knedl1k/decaf/sw/README.md

# Dir Structure

- [**`arduino`**](./arduino): code ran on Arduino.
- [**`graphs`**](./graphs): code to generate data for TikZ scripts.
- [**`recognition`**](./recognition): whole pipeline for training, evaluating,
and deploying the *decaf* model.
