knedl1k/decaf/thesis/src/acknowledgments.tex

%!TEX root = ../main.tex

\begin{changemargin}{0.8cm}{0.8cm}

~\vfill{}

\section*{Acknowledgments}
\vskip 0.5em
I would like to express my gratitude to my thesis supervisor, Ing. Jakub Paplhám, for his valuable guidance, advice and time dedicated to this work. I would also like to thank my colleague Martin Erben for helpful discussions during the preparation of this thesis and throughout our entire studies. Finally, my special thanks go to my girlfriend Natália and my family for their continuous support and encouragement throughout my studies.

\vskip 1em

The access to the computational infrastructure of the \href{https://opvvv.msmt.cz}{OP VVV} funded project \texttt{CZ.02.1.01\slash 0.0\slash 0.0\slash 16\_019\slash 0000765} \enquote{\href{https://rci.cvut.cz}{Research Center for Informatics}} is also gratefully acknowledged.

\vskip 2.5cm

\end{changemargin}
