knedl1k/decaf/thesis/src/disclaimer.tex

%!TEX root = ../main.tex

\begin{changemargin}{0.8cm}{0.8cm}

~\vfill{}

\section*{Disclaimer}
\vskip 0.5em
All trademarks, service marks, trade names, and product names mentioned in this thesis (e.g., \ii{Magic: The Gathering}, \ii{Pokémon}, \ii{Yu-Gi-Oh!}) are the property of their respective owners. Their use in this document is for identification and academic purposes only and does not imply endorsement. Card imagery and graphical assets used in this thesis remain the intellectual property of their original publishers.

\vskip 2.5cm

\end{changemargin}
