knedl1k/decaf/thesis/src/abbreviations.tex

%!TEX root = ../main.tex

\acro{arcface}{ArcFace}{Additive Angular Margin Loss}
\acro{GPIO}{GPIO}{General-purpose input/output}
\acro{PWM}{PWM}{Pulse Width Modulation}
\acro{ONNX}{ONNX}{Open Neural Network Exchange}
\acro{SGD}{SGD}{Stochastic Gradient Descent}
\acro{CNN}{CNN}{Convolutional Neural Network}
\acro{SBC}{SBC}{Single Board Computer}
\acro{BOM}{BOM}{Bill of Materials}
\acro{CTU}{CTU}{Czech Technical University}
\acro{TCG}{TCG}{Trading Card Game}
\acro{FOSS}{FOSS}{Free and open-source software}
\acro{OCR}{OCR}{Optical Character Recognition}
\acro{NER}{NER}{Named Entity Recognition}
\acro{YOLO}{YOLO}{You Only Look Once}
\acro{ResNet}{ResNet}{Residual neural network}
\acro{VSL}{VSL}{Visual Similarity Learning}
\acro{DFC}{DFC}{Double-Faced card}
\acro{UUID}{UUID}{Universally unique identifier}
\acro{URI}{URI}{Uniform Resource Identifier}
\acro{MTG}{MTG}{\ii{Magic: The Gathering}}
\acro{DML}{DML}{Deep Metric Learning}
\acro{FMR}{FMR}{False Match Rate}
\acro{TMR}{TMR}{True Match Rate}
\acro{DDP}{\texttt{DDP}}{\texttt{DistributedDataParallel}}
\acro{GIL}{GIL}{Global Interpreter Lock}
\acro{STR}{STR}{Scene Text Recognition}
