knedl1k/decaf/thesis/src/chapters/05_software.tex

%!TEX root = ../main.tex

\chapter{System Implementation \& Integration}\label{chap:sw}
The software ecosystem of the robotic sorter spans two distinct computing environments: a high-performance cluster for model optimization and a low-power edge computing architecture for real-time robotic control and inference. This chapter details the implementation of both systems and their integration.

\section{Scalable Training Architecture}
Training a deep metric learning model on a dataset with extreme cardinality introduces significant computational bottlenecks. Specifically, the weight matrix $\mathbf{W}$ in the \ac{arcface} head requires substantial VRAM, scaling linearly with the number of unique cards. To address this, the training pipeline was designed for high-throughput distributed execution.

\subsection{Distributed Data Parallelism and Synchronization}
The model optimization is parallelized across multiple compute nodes and accelerators using PyTorch's~\cite{paszke2019pytorch} \ac{DDP}. Unlike standard \texttt{DataParallel}, which suffers from Python \ac{GIL} contention and uneven memory distribution, \ac{DDP} spawns independent processes for each device.

To manage the massive 150+\,GB dataset of clean templates, a \texttt{DistributedSampler} is employed within the data loading pipeline. It mathematically partitions the dataset indices among the active workers. For instance, in a 4-GPU topology, each device independently loads and processes exactly 25\,\% of the dataset per epoch. The \ac{DDP} backend (via the NCCL protocol) then asynchronously synchronizes the calculated gradients across all nodes before the optimizer steps, drastically reducing training times.

However, running small batches on individual GPUs severely destabilizes the mean and variance calculations inside standard Batch Normalization layers. To maintain mathematical consistency across distributed workers, standard layers were replaced with Synchronized Batch Normalization (\texttt{SyncBatchNorm}). This ensures that the variance and mean are computed globally across all participating devices, stabilizing the embedding space optimization.

\subsection{Mixed Precision Training}
To further optimize the memory footprint and memory bandwidth, \ii{mixed precision} was integrated into the training loop. The forward pass and loss computation are executed in \texttt{bfloat16} (Brain Floating Point)~\cite{kalamkar2019bfloat}, a format that preserves the dynamic range of 32-bit floats while halving the memory requirement. The weights and optimizer states remain in \texttt{float32} to prevent precision degradation during gradient updates. This approach effectively doubles the maximum allowable batch size, leading to smoother gradient estimates and faster convergence.

\section{Edge Vision Pipeline}
Once the network is trained, it must be deployed to the \ac{SBC} (Raspberry Pi) governing the robotic platform. And because the \ac{SBC} operates with strict computational and memory constraints (1\,GB RAM and a low-power CPU), the software pipeline must be optimized.

\subsection{Image Localization and Homography}
Before the captured image is passed to the neural network, the physical card must be accurately localized. Simple bounding-box detection (e.g., standard Canny edge detection) frequently fails due to dual borders introduced by plastic card sleeves and severe specular highlights breaking the continuous edge lines.

To resolve this, an OpenCV algorithm was implemented, as formalized in \Cref{alg:crop_card}. The preprocessing sequence proceeds as follows:
\begin{enumerate}
    \item \ii{Filtering}: The raw camera frame is converted to grayscale and passed through a Bilateral Filter. This preserves sharp edges while smoothing out the background texture (e.g., a wooden table).
    \item \ii{Morphological Closing}: After applying a Canny edge detector, a morphological closing operation (using a $9 \times 9$ kernel) is performed. This step is critical, as it mathematically bridges the gaps in the edge map caused by bright light reflections on the card sleeves.
    \item \ii{Minimum Area Rectangle}: Instead of tracing exact polygons, the algorithm extracts the \texttt{minAreaRect} of the largest contour. This cleanly bounds the card while ignoring bent corners or crinkled sleeve edges.
    \item \ii{Perspective Warp}: The four corners of the rectangle are ordered and mapped to a fixed matrix. A perspective transform (homography) is then applied to extract a perfectly orthogonal, standardized card image.
\end{enumerate}

\begin{algorithm}[htbp]
    \caption{Card Localization and Homography Extraction}
    \label{alg:crop_card}
    \begin{algorithmic}[1]
    \Require Raw high-resolution image $I_{\text{raw}}$, Target Width $W$, Target Height $H$
    \Ensure Orthogonally warped card image $I_{\text{crop}}$

    \State $I_{\text{work}} \gets \text{Downscale}(I_{\text{raw}})$ \Comment{Optimizes processing speed on \ac{SBC}}
    \State $I_{\text{gray}} \gets \text{RGBtoGrayscale}(I_{\text{work}})$
    \State $I_{\text{blur}} \gets \text{BilateralFilter}(I_{\text{gray}}, d=11, \sigma_{\text{color}}=75, \sigma_{\text{space}}=75)$
    \State $I_{\text{edges}} \gets \text{CannyEdgeDetector}(I_{\text{blur}}, \tau_{\text{low}}=30, \tau_{\text{high}}=150)$
    \State $K \gets \text{RectangularKernel}(9 \times 9)$
    \State $I_{\text{closed}} \gets \text{MorphologicalClose}(I_{\text{edges}}, K)$ \Comment{Bridges gaps caused by glare}
    \State $\mathcal{C} \gets \text{FindContours}(I_{\text{closed}})$
    \If{$\mathcal{C}$ is empty}
        \State \Return $\text{Resize}(I_{\text{raw}}, W, H)$ \Comment{Fallback if detection fails}
    \EndIf
    \State $c_{\text{max}} \gets \arg\max_{c \in \mathcal{C}} \text{Area}(c)$
    \State $rect \gets \text{MinAreaRect}(c_{\text{max}})$ \Comment{Ignores bent corners and sleeve artifacts}
    \State $P_{\text{src}} \gets \text{OrderPointsToCorners}(rect)$ \Comment{Top-Left, Top-Right, Bottom-Right, Bottom-Left}
    \State $P_{\text{src}} \gets P_{\text{src}} \times \text{UpscaleFactor}$ \Comment{Map coordinates back to original high-res image}
    \State $P_{\text{dst}} \gets \{(0,0), (W,0), (W,H), (0,H)\}$
    \State $M \gets \text{GetPerspectiveTransform}(P_{\text{src}}, P_{\text{dst}})$
    \State $I_{\text{crop}} \gets \text{WarpPerspective}(I_{\text{raw}}, M, W, H)$
    \State \Return $I_{\text{crop}}$
    \end{algorithmic}
\end{algorithm}

\subsection{\acs{ONNX} Runtime and Sequential Inference}
Running a full PyTorch environment on the Raspberry Pi introduces an unacceptable memory overhead. Therefore, the trained \ac{ResNet}-50 backbone is exported to the \acf{ONNX} format~\cite{onnxruntime}, stripping away the \ac{arcface} head and all gradient-tracking graphs. Inference is executed via the \texttt{ONNX Runtime} using the \texttt{CPUExecutionProvider}.

Because cards can be placed onto the sorting platform in any orientation, the system must process the image safely. Instead of batching the original and a $180^\circ$ rotated copy into a single tensor (which spikes memory consumption and risks an Out-Of-Memory termination on the \ac{SBC}), the pipeline executes sequentially. The system extracts a 512-dimensional vector for both orientations individually, $L_2$-normalizes them, and selects the vector that yields the highest cosine similarity against the database. 

The reference database itself is stored as a compressed \texttt{.npz} file containing pre-computed NumPy matrices, enabling instantaneous vector dot-products to determine the final card identity. The complete sequential inference logic, designed specifically for resource-constrained environments, is detailed in \Cref{alg:inference}.
\begin{algorithm}[htbp]
    \caption{Resource-Constrained Orientation Selection and Retrieval}
    \label{alg:inference}
    \begin{algorithmic}[1]
    \Require Cropped Image $I_{\text{crop}}$, ONNX Model $\mathcal{M}$, Database Matrix $\mathbf{D}$, Top-$k$
    \Ensure Best matching card identity and orientation

    \State $I_0 \gets \text{Preprocess}(I_{\text{crop}})$
    \State $I_{180} \gets \text{Preprocess}(\text{Rotate180}(I_{\text{crop}}))$

    \Comment{Sequential execution to prevent Out-Of-Memory errors on the \ac{SBC}}
    \State $\mathbf{v}_0 \gets L_2\text{Normalize}(\mathcal{M}\text{.forward}(I_0))$
    \State $\mathbf{v}_{180} \gets L_2\text{Normalize}(\mathcal{M}\text{.forward}(I_{180}))$

    \State $\mathbf{s}_0 \gets \mathbf{v}_0 \cdot \mathbf{D}^\intercal$ \Comment{Compute cosine similarities against the entire database}
    \State $\mathbf{s}_{180} \gets \mathbf{v}_{180} \cdot \mathbf{D}^\intercal$

    \If{$\max(\mathbf{s}_{180}) > \max(\mathbf{s}_0)$}
        \State $\mathbf{s}_{\text{best}} \gets \mathbf{s}_{180}$
        \State $\text{orientation} \gets 180^\circ$
    \Else
        \State $\mathbf{s}_{\text{best}} \gets \mathbf{s}_0$
        \State $\text{orientation} \gets 0^\circ$
    \EndIf

    \State $\mathcal{I}_{\text{topK}} \gets \text{GetIndicesOfLargest}(\mathbf{s}_{\text{best}}, k)$
    \State \Return $\text{DatabaseNames}[\mathcal{I}_{\text{topK}}], \text{orientation}$
    \end{algorithmic}
\end{algorithm}

\section{Hardware Control Software}
The physical operation of the robot relies on a master-slave software architecture, dividing responsibilities between asynchronous high-level logic and real-time execution. The Arduino Uno acts as the slave device, executing a deterministic control loop. It communicates with the Raspberry Pi (the master) via a standard USB serial interface operating at a baud rate of 57,600 bps.

\subsection{Closed-Loop Positional Control}
While stepper motors are typically driven in an open-loop configuration, this system implements a closed-loop positioning algorithm to prevent mechanical drift and missed steps. 

The absolute rotational position of the main arm is continuously monitored using the AS5147 magnetic encoder. To bypass hardware SPI constraints and pin conflicts, the microcontroller queries the sensor using a custom software SPI implementation (bit-banging) adapted from an existing open-source routine\footnote{The bit-banging implementation for the AS5147 encoder was adapted from \cite{mcr2019as51457}, licensed under GNU GPLv3.}. The raw 14-bit positional data is extracted, validated via a parity bit check and converted into an angular value ($-180^\circ$ to $180^\circ$).

The motion is controlled by a target-seeking loop. The Arduino pulses the TMC2209 driver, stepping the motor while continuously re-evaluating the encoder position. Movement stops only when the absolute angular error falls within a defined tolerance ($\pm 0.5^\circ$) or an overshoot is detected. Although this basic approach guarantees target acquisition, the abrupt termination of movement can cause minor mechanical oscillations at the target workstations. To achieve smoother deceleration and stabilization, future firmware versions will replace this logic with a full Proportional-Integral-Derivative (PID) control scheme. The current control flow is outlined in \Cref{alg:closed_loop}.
\begin{algorithm}[htbp]
    \caption{Closed-Loop Stepper Motor Positioning}
    \label{alg:closed_loop}
    \begin{algorithmic}[1]
    \Require Target angle $\theta_{\text{target}}$, Tolerance $\tau$ (e.g., $0.5^\circ$)
    \Ensure Manipulator reaches $\theta_{\text{target}}$ without mechanical oscillation
    
    \State $e_{\text{prev}} \gets 0$
    \State $\text{first\_run} \gets \text{True}$
    
    \Loop
        \State $\theta_{\text{current}} \gets \text{ReadEncoderData}()$ \Comment{Via bit-banged SPI}
        \State $e \gets \theta_{\text{target}} - \theta_{\text{current}}$
        
        \Comment{Terminate if within tolerance or an overshoot occurs}
        \If{$|e| \leq \tau$ \textbf{or} (\textbf{not} $\text{first\_run}$ \textbf{and} $e \cdot e_{\text{prev}} < 0$)}
            \State \textbf{break}
        \EndIf
        
        \State $\text{first\_run} \gets \text{False}$
        \State $e_{\text{prev}} \gets e$
        
        \If{$e > 0$}
            \State $\text{SetMotorDirection}(\text{FORWARD})$
        \Else
            \State $\text{SetMotorDirection}(\text{REVERSE})$
        \EndIf
        
        \State $\text{PulseStepperDriver}()$
        \State $\text{Wait}(\text{STEP\_DELAY})$
    \EndLoop
    \end{algorithmic}
\end{algorithm}

\subsection{Kinematic Sequences and Synchronization}
To minimize the communication overhead between the Raspberry Pi and the Arduino, the low-level mechanical synchronization is abstracted into three hard-coded macro sequences. The master device issues a single ASCII character (\texttt{'A'}, \texttt{'B'} or \texttt{'C'}), prompting the Arduino to autonomously orchestrate the main stepper, the Z-axis servo and the pneumatic solenoid.

These sequences correspond directly to the physical workstations illustrated in \Cref{fig:system_overview}:
\begin{itemize}
    \item \bb{Sequence A (Input):} The arm traverses to the input hopper. The Z-axis servo lowers the end-effector, the 24\,V solenoid valve is energized to generate a vacuum and the card is lifted.
    \item \bb{Sequence B (Inspection):} The arm moves the card into the camera's field of view. Once the arm stabilizes, the Arduino transmits an \texttt{"R"} (Ready) character back over the serial interface. This acts as a hardware trigger for the Raspberry Pi to capture the image.
    \item \bb{Sequence C (Output):} The arm proceeds to the output sorting tray, lowers the Z-axis and de-energizes the solenoid. This vents the pneumatic circuit to the atmosphere, safely releasing the card.
\end{itemize}
