knedl1k/decaf/presentation/slides/1_2026/main.pdf

## Automated Recognition and

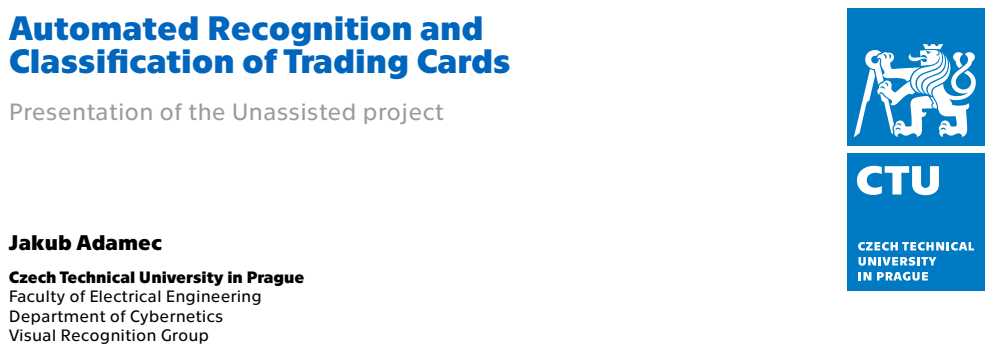
[picture p11: page 1]

Classification of Trading Cards

Presentation of the Unassisted project

Jakub Adamec
Czech Technical University in Prague
Faculty of Electrical Engineering
Department of Cybernetics
Visual Recognition Group

### Motivation and Objective

The problem

I Manual sorting of trading cards (TCG) is time-consuming and prone to errors. I Existing commercial solutions (e.g., CardBot) are proprietary and/or expensive. I Many different similar cards. MTG has >100k unique cards.

Objectives of the work

I Software: Recognition pipeline that recognizes cards even from poor-quality photos.
I Hardware: Affordable and widely available components (Arduino, stepper motors...).
I The entire project FOSS and well documented so that it can serve as educational material.
1 / 7 | Jakub Adamec

### Hardware: Concept

I Focus on affordable components.
I Vacuum suction cups, stepper motor, pneumatic valve, hall encoder.
I Milestone reached: Precise stepper motor control using rotation encoders feedback loop.

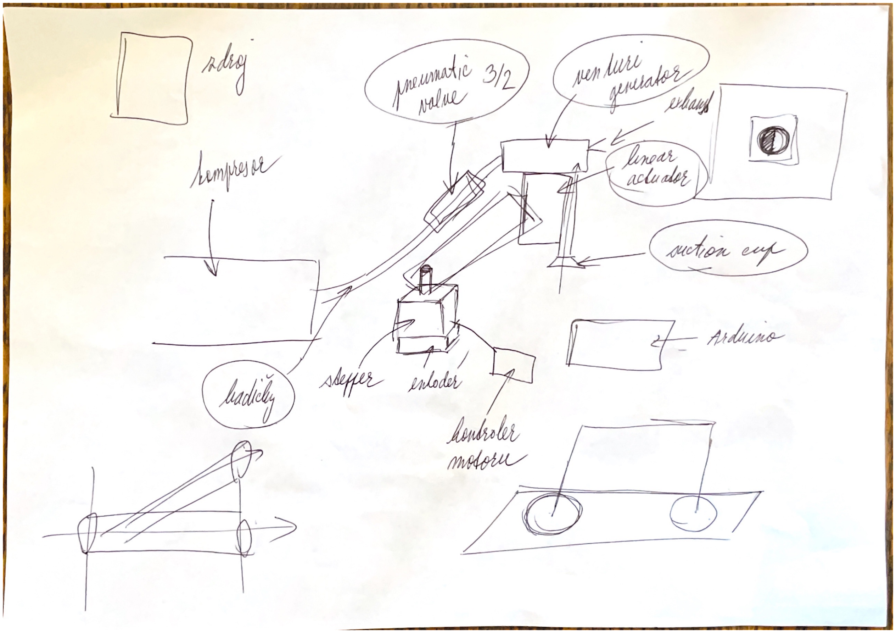
[picture p12: figure]

2 / 7 | Jakub Adamec

### Data Acquisition & Augmentation

Synthetic Dataset Generation
I Real-world labeled dataset is non-existent. I Scans retrieved via Scryfall API.
I Custom naming convention for human-readability & uniqueness:

Bridge the Domain Gap
I Heavy augmentation pipeline required to match camera output.
I Geometric: Random perspective, rotation. I Photometric: Blur, noise, lighting conditions, partial occlusions.

## filename = edition_collectorNumber_name-UUID.png zen_21_kor-outfitter-00006596-1166-4a79-8443-ca9f82e6db4e.png

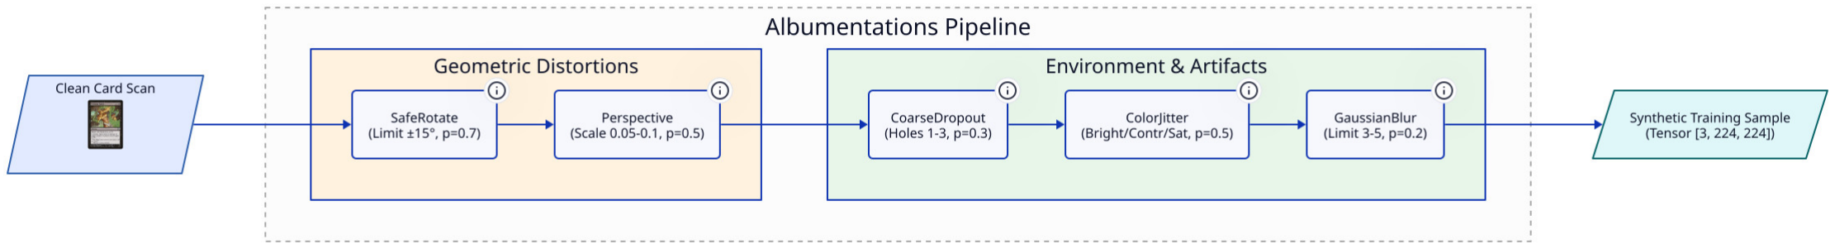
[picture p13: figure]

3 / 7 | Jakub Adamec

### Softmax vs ArcFace

Limitations of Standard Softmax

I Huge number of classes (10⁵+) → computationally expensive. I Open-set problem: New cards are released frequently.

Metric Learning Approach (ArcFace)

I Learning a mapping to a hypersphere embedding space.
I Intra-class compactness. Images of the same card are pulled together. I Intra-class separability. Different cards are pushed apart.
I Inference via Cosine Similarity (Nearest Neighbor).
4 / 7 | Jakub Adamec

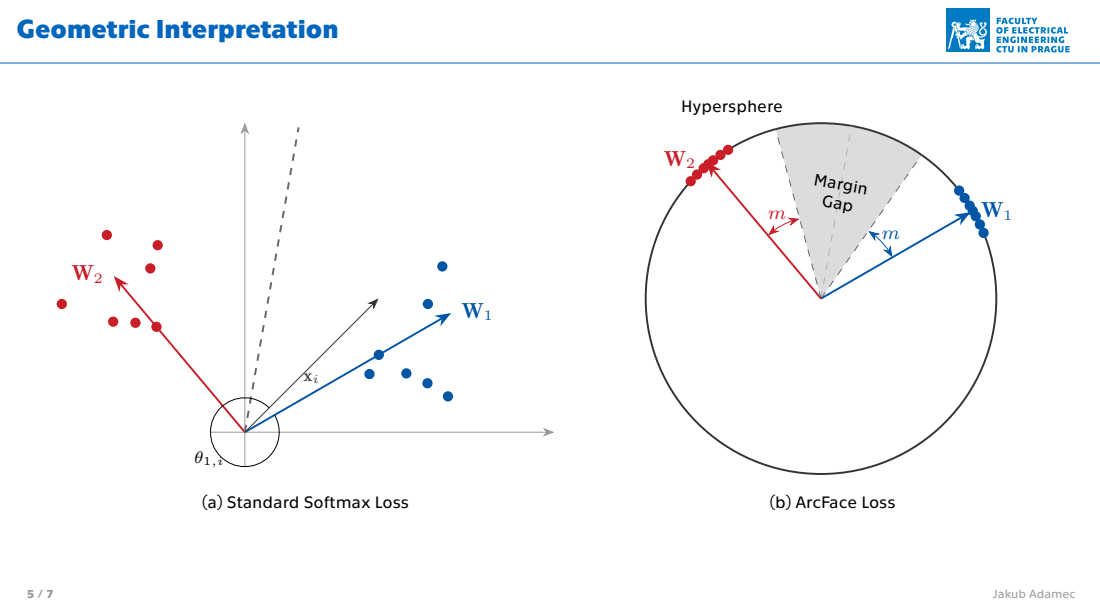
[picture p14: page 6]
Geometric Interpretation; Hypersphere; Margin Gap; (b) ArcFace Loss; Jakub Adamec

(a) Standard Softmax Loss

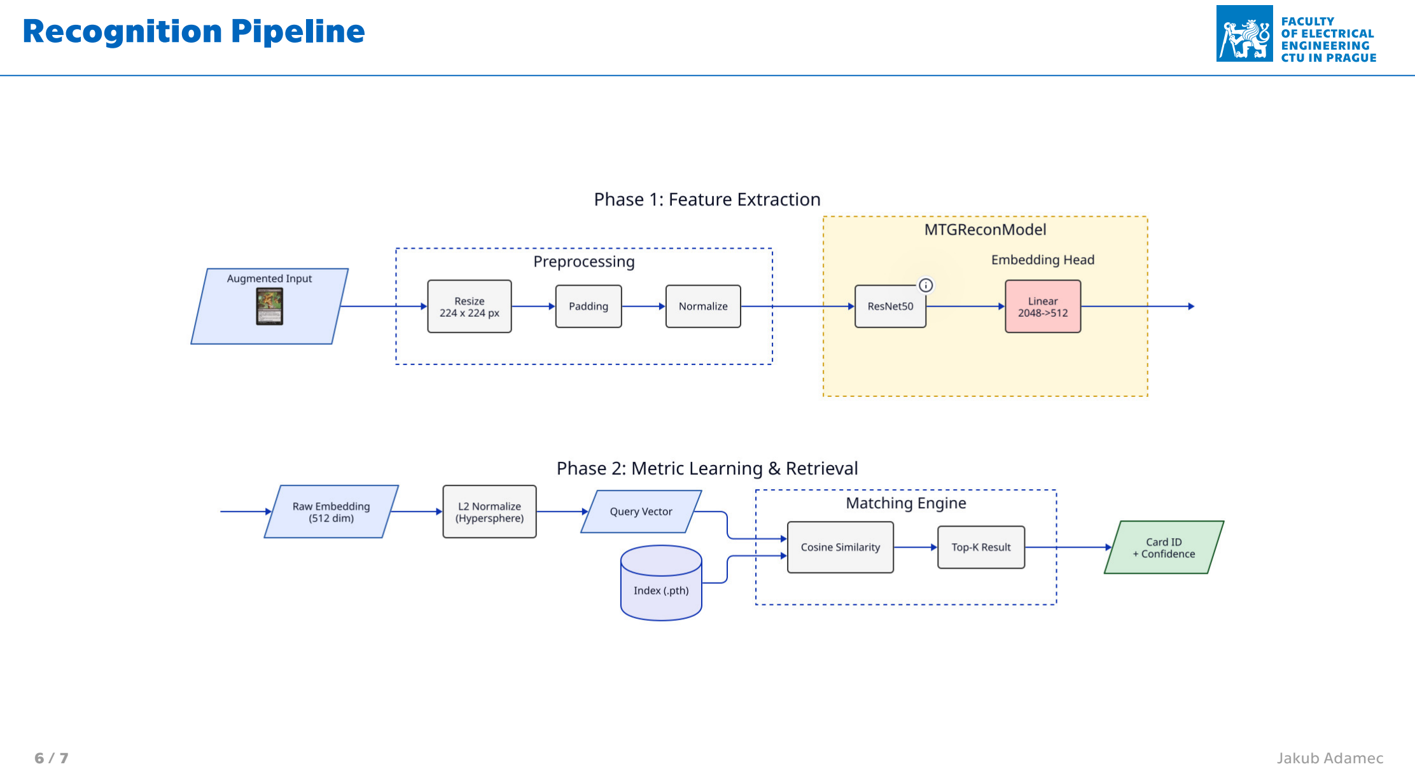
[picture p15: page 7]

### Recognition Pipeline

6 / 7 | Jakub Adamec

### Conclusion and Future Work

Summary

I Basic HW control operational.
I Recognition pipeline implemented (Synthetic Data + ArcFace). I Support for MultiGPU training.

Next Steps

I Hyperparameter sweep (Weights & Biases).
I Finalize mechanical construction.
I Full integration of the recognition module with the robotic control. I Final evaluation on a physical test set.
7 / 7 | Jakub Adamec
