knedl1k/decaf/thesis/main.tex

% enable this to activate the version for PRINT
% disable this to make the pdf symmetric and without white pages
% => asymmetric alternating left/right margins
% \newcommand*{\printversion}{}%

%% | ---------------- document meta information --------------- |

\newcommand{\Author}{Jakub Adamec}
\newcommand{\Department}{Department of Cybernetics}
\newcommand{\Supervisor}{Ing. Jakub Paplhám}
% \newcommand{\SupervisorSpecialist}{Ing. My Specialist, Ph.D.}
\newcommand{\Programme}{Open Informatics}
\newcommand{\Field}{Artificial Intelligence and Computer Science}
\newcommand{\Title}{Automated Recognition and\texorpdfstring{\\[0.5em]}{ }Classification of Trading Cards}
\newcommand{\Keywords}{Trading Card Games, Magic: The Gathering, Automated Sorting, Deep Metric Learning, Computer Vision, ArcFace, Nearest Neighbor Search, Synthetic Data Generation, Domain Shift, Image Retrieval, Open-Source Hardware, Robotics, Pick-and-Place Mechanism, Pneumatic Handling.}
\newcommand{\KlicovaSlova}{Sběratelské karetní hry, Magic: The Gathering, automatizované třídění, hluboké metrické učení, počítačové vidění, ArcFace, hledání nejbližšího souseda, generování syntetických dat, posun domény, vyhledávání obrázků, open-source hardware, robotika, pick-and-place mechanismus, manipulace pomocí podtlaku.}
% \newcommand{\Year}{}
% \newcommand{\Month}{December}
\newcommand{\Date}{\today}
\newcommand{\Location}{Prague}

%% | ---------------------- configuration --------------------- |

% most of the configuration stuff happens here
\input{src/document_setup.tex}

\definecolor{academicBlue}{RGB}{0, 85, 164}
\definecolor{academicRed}{RGB}{200, 30, 40}
\definecolor{marginGray}{RGB}{220, 220, 220}

%% | ---------------------- the contents ---------------------- |

\input{src/abbreviations.tex}
\begin{document}

% this will prevent unwanted line overflows
% http://latexref.xyz/_005cfussy-_0026-_005csloppy.html
\sloppy

\pagenumbering{roman}

%% --------------------------------------------------------------
%% |                         Title page                         |
%% --------------------------------------------------------------

\input{src/title}

% set up the page style for the "intro" pages
\pagestyle{plain}

%% --------------------------------------------------------------
%% |                         Assignment                         |
%% --------------------------------------------------------------

\conditionalClearPage

\includepdf[pages=-]{src/assignment.pdf}

%% --------------------------------------------------------------
%% |                Declaration & Disclaimer                    |
%% --------------------------------------------------------------

\conditionalClearPage

\includepdf[pages=-]{src/declaration.pdf}

\input{src/disclaimer.tex}

%% --------------------------------------------------------------
%% |                       Acknowledgments                      |
%% --------------------------------------------------------------

\conditionalClearPage

\input{src/acknowledgments.tex}

%% --------------------------------------------------------------
%% |                          Abstracts                         |
%% --------------------------------------------------------------

\conditionalClearPage

\input{src/abstract_en.tex}

\conditionalClearPage

\input{src/abstrakt_cz.tex}

%% --------------------------------------------------------------
%% |                        Abbreviations                       |
%% --------------------------------------------------------------

\conditionalClearPage

\begin{changemargin}{0.8cm}{0.8cm}

~\vfill{}

% \section*{Abbreviations}

\printacronyms[name=Abbreviations, heading=section*]
% this will print only the used abbreviations

\vskip 2.5cm

\end{changemargin}

\conditionalClearPage

%% --------------------------------------------------------------
%% |                      Table of contents                     |
%% --------------------------------------------------------------

\tableofcontents

\conditionalClearPage

% set up the full page style with normal page numbering
\pagestyle{full}
\pagenumbering{arabic}

%% --------------------------------------------------------------
%% |                         Main Text                          |
%% --------------------------------------------------------------

\input{src/chapters.tex}

%% --------------------------------------------------------------
%% |                         References                         |
%% --------------------------------------------------------------

\chapter{References}

\printbibliography[heading=none,title={}]

%% --------------------------------------------------------------
%% |                         Appendices                         |
%% --------------------------------------------------------------

\input{src/appendices.tex}

\end{document}
