knedl1k/decaf/presentation/robotic-arm_cards.pdf

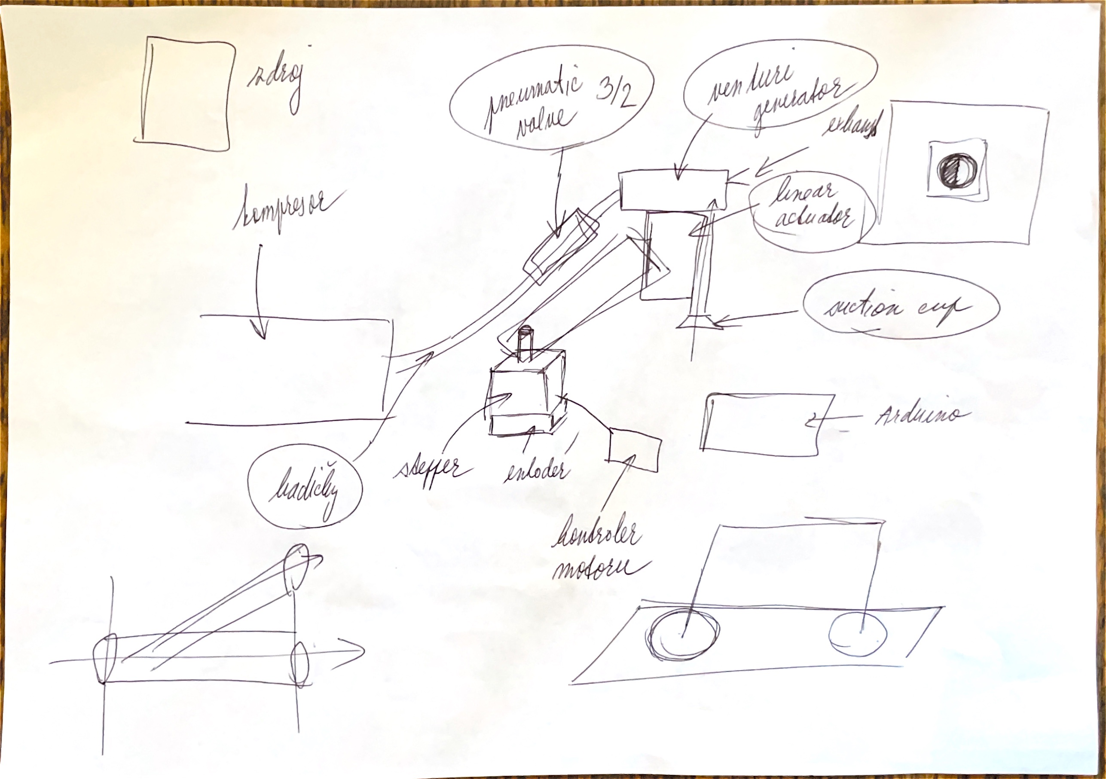
[picture p46: page 1]
