knedl1k/decaf/thesis/fig/sketch/z_axis_v1.png

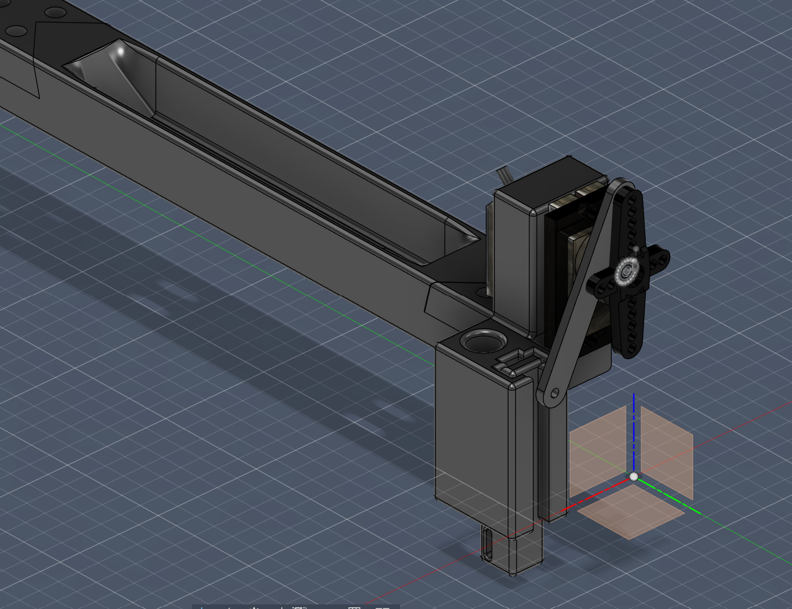
thesis/fig/sketch/z_axis_v1.png
