knedl1k/decaf/hw/STL/DummyArm.stl

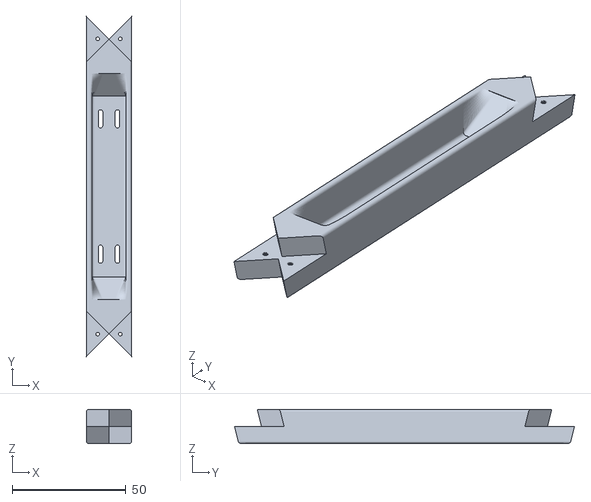
[picture p48: CAD file, 2026-05-22]
hw/STL/DummyArm.stl
20.0 x 149.7 x 15.0
