knedl1k/decaf/hw/STL/MotorHousing.stl

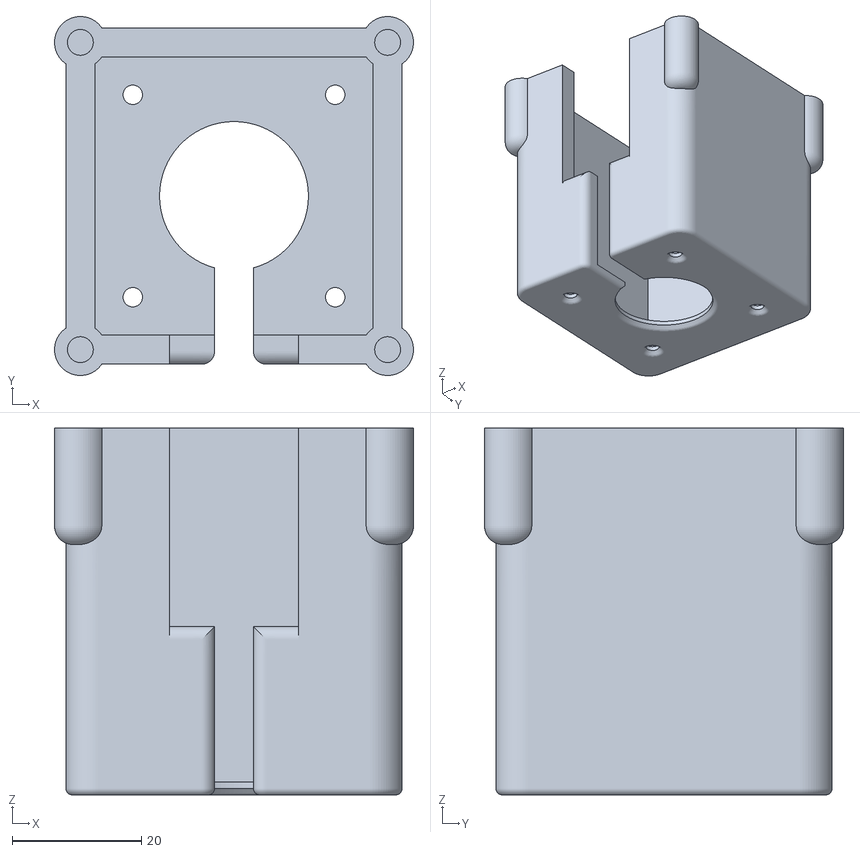
[picture p49: CAD file, 2026-05-22]
hw/STL/MotorHousing.stl
55.5 x 55.5 x 56.7
