knedl1k/decaf/hw/STL/VenturiHolder.stl

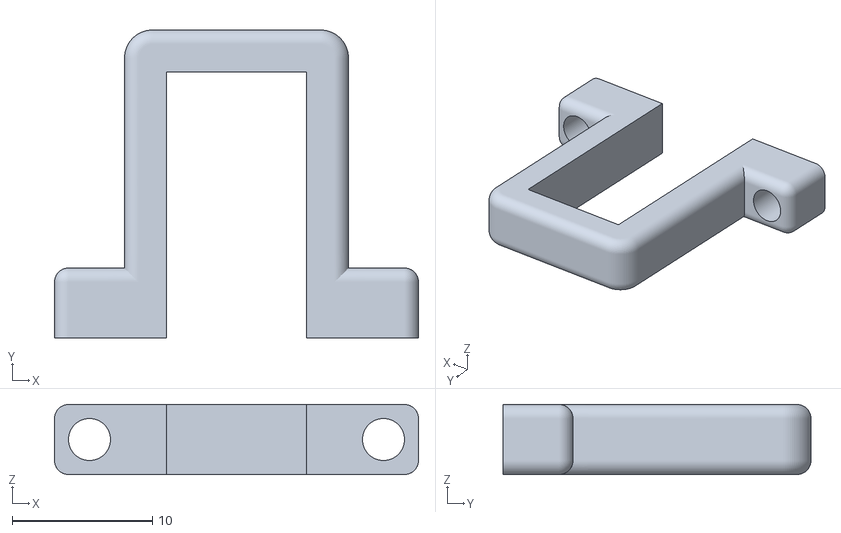
[picture p50: CAD file, 2026-05-22]
hw/STL/VenturiHolder.stl
26.0 x 22.0 x 5.00
