knedl1k/decaf/hw/STL/Linkage.stl

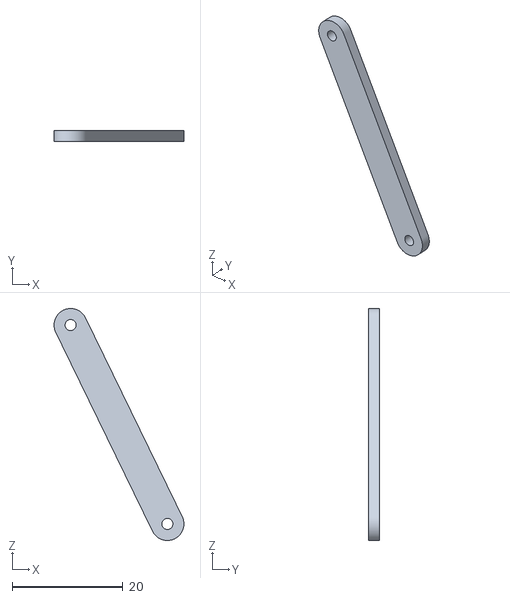
[picture p51: CAD file, 2026-05-22]
hw/STL/Linkage.stl
23.5 x 2.00 x 42.0
