knedl1k/decaf/hw/STL/ArmBody.stl

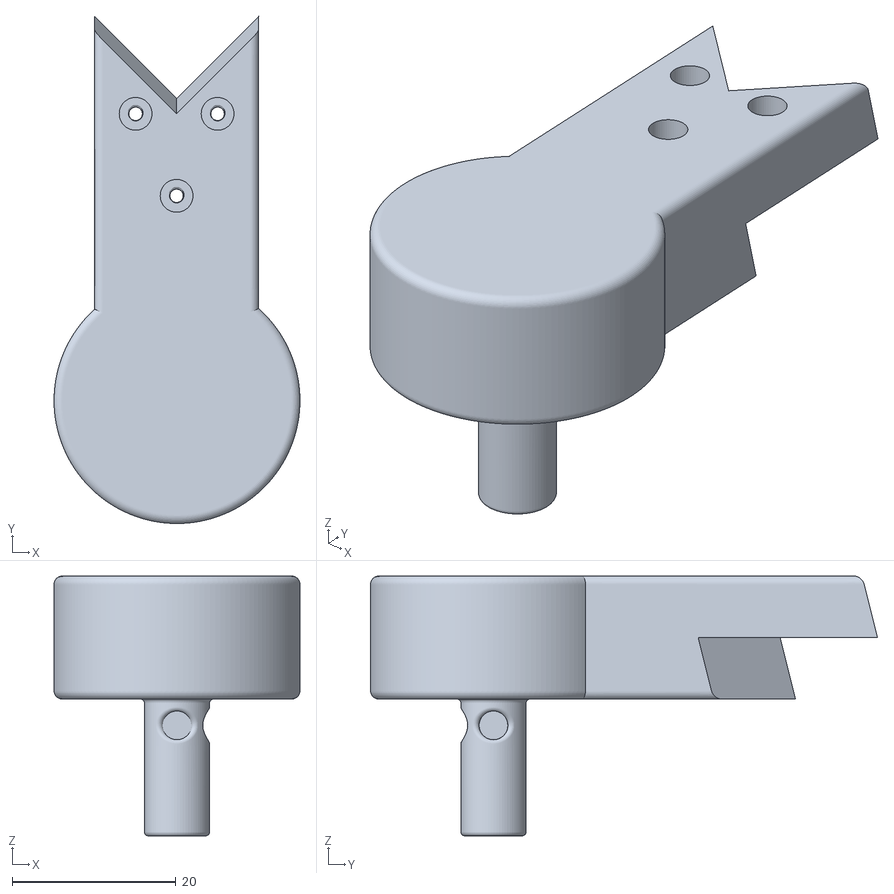
[picture p52: CAD file, 2026-05-22]
hw/STL/ArmBody.stl
30.0 x 61.8 x 31.7
