knedl1k/decaf/hw/STL/MotorMount.stl

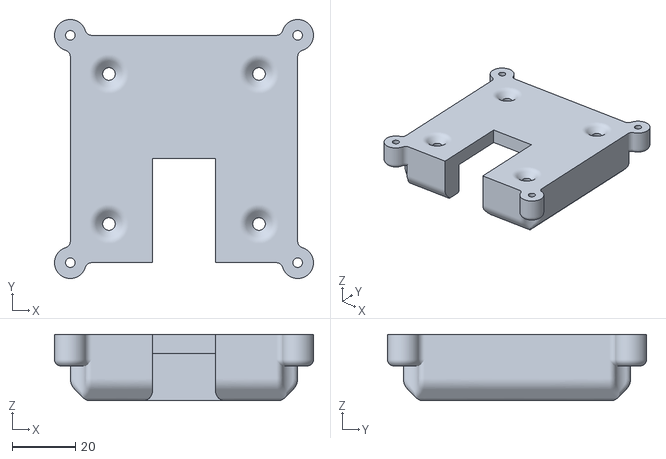
[picture p53: CAD file, 2026-05-22]
hw/STL/MotorMount.stl
82.0 x 82.0 x 21.0
