knedl1k/decaf/hw/STL/VenturiNozzle.stl

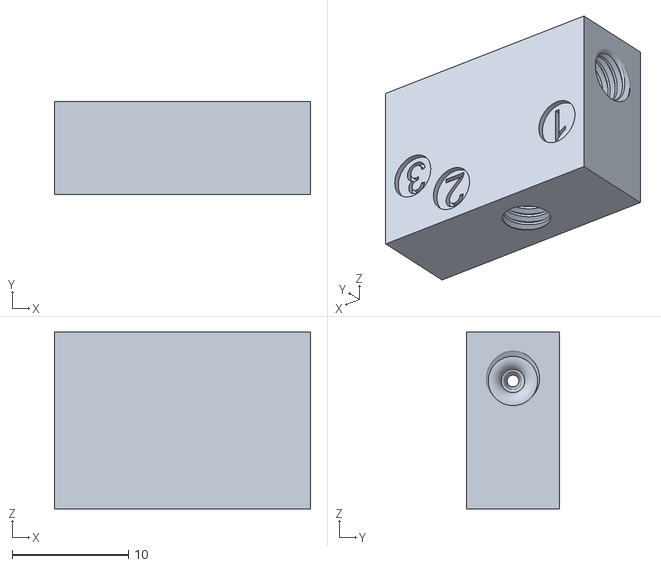
[picture p54: CAD file, 2026-05-22]
hw/STL/VenturiNozzle.stl
22.0 x 8.00 x 15.2
