knedl1k/decaf/hw/STL/ServoPart.stl

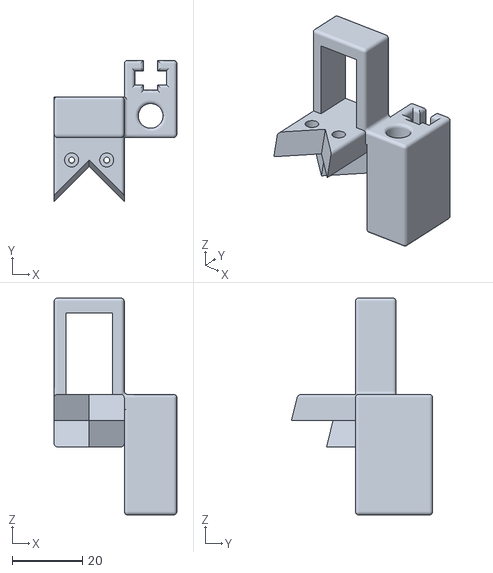
[picture p55: CAD file, 2026-05-22]
hw/STL/ServoPart.stl
35.0 x 40.2 x 61.8
