knedl1k/decaf/hw/STL/RPiCameraMount.stl

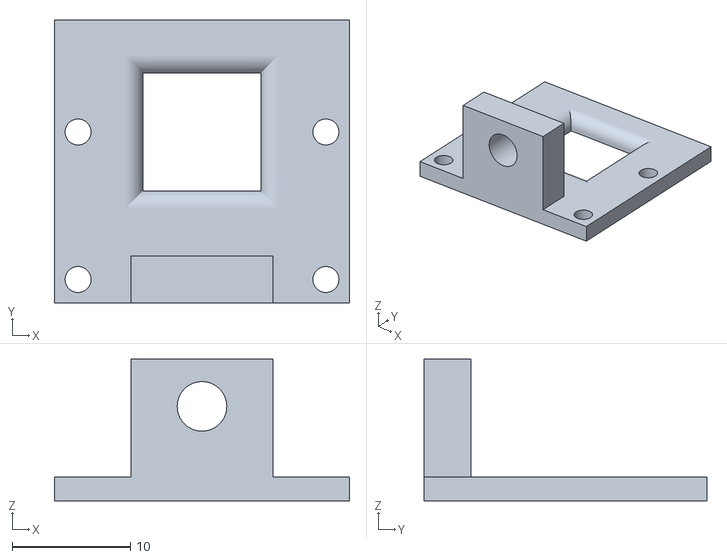
[picture p56: CAD file, 2026-05-22]
hw/STL/RPiCameraMount.stl
25.0 x 24.0 x 12.0
