knedl1k/decaf/hw/STL/ArmDoubleSided.stl

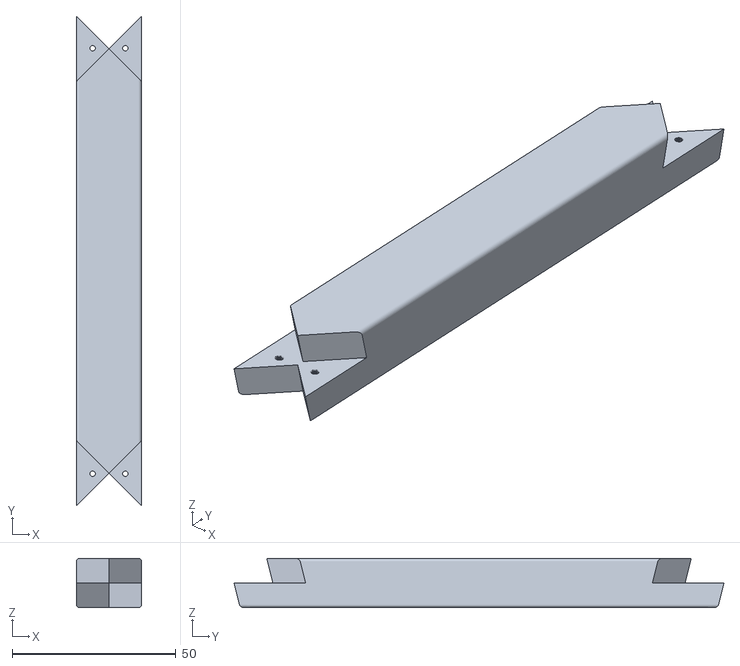
[picture p57: CAD file, 2026-05-22]
hw/STL/ArmDoubleSided.stl
20.0 x 149.7 x 15.0
