knedl1k/decaf/hw/STL/BaseOffset.stl

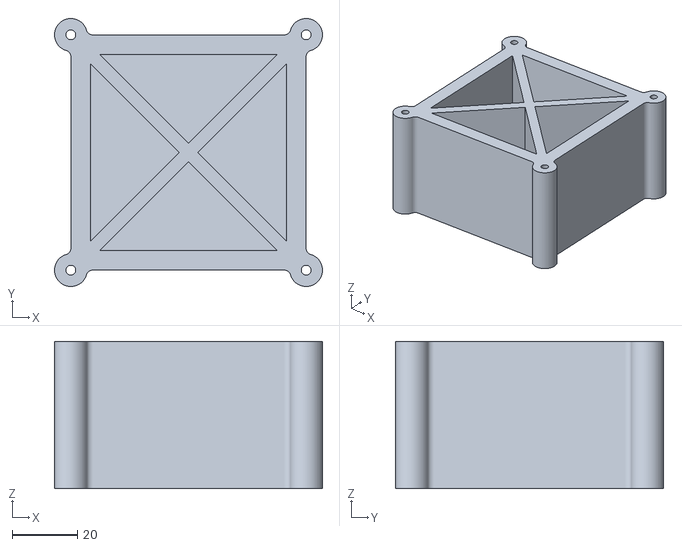
[picture p58: CAD file, 2026-05-22]
hw/STL/BaseOffset.stl
82.0 x 82.0 x 45.0
