knedl1k/decaf/hw/STL/CardHolder.stl

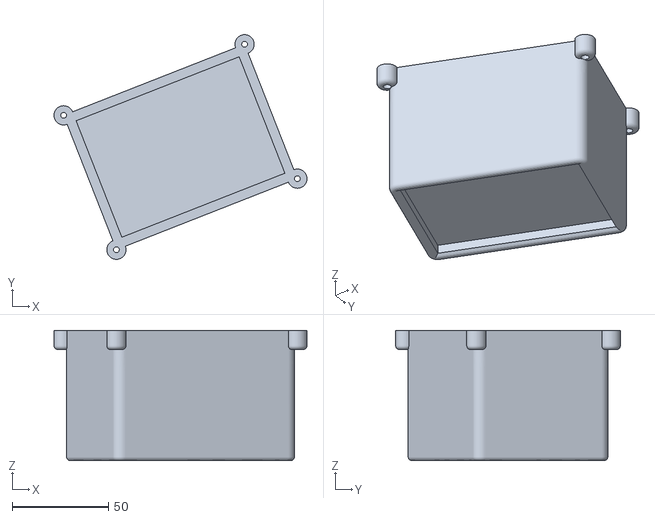
[picture p59: CAD file, 2026-05-22]
hw/STL/CardHolder.stl
131.4 x 116.7 x 67.7
