knedl1k/decaf/hw/STL/Slider.stl

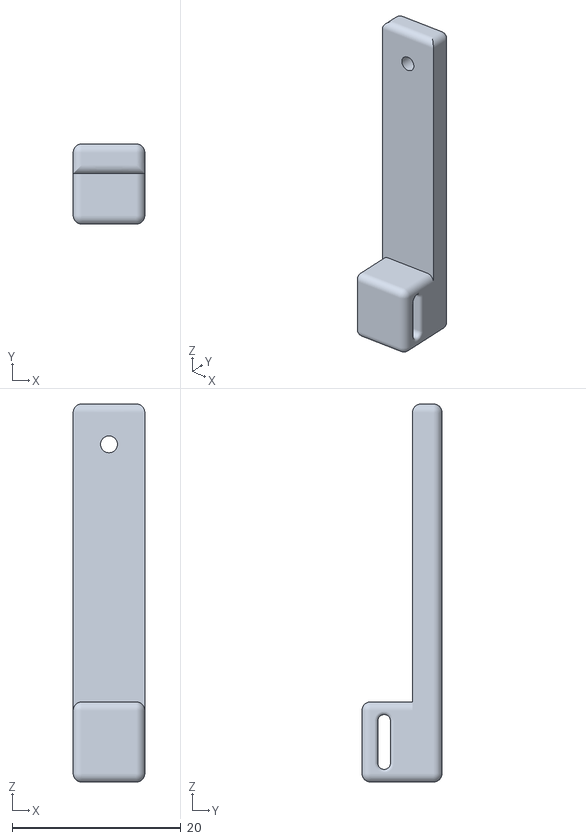
[picture p60: CAD file, 2026-05-22]
hw/STL/Slider.stl
8.50 x 9.50 x 44.9
