knedl1k/decaf/thesis/fig/schematics/driver-crop.pdf

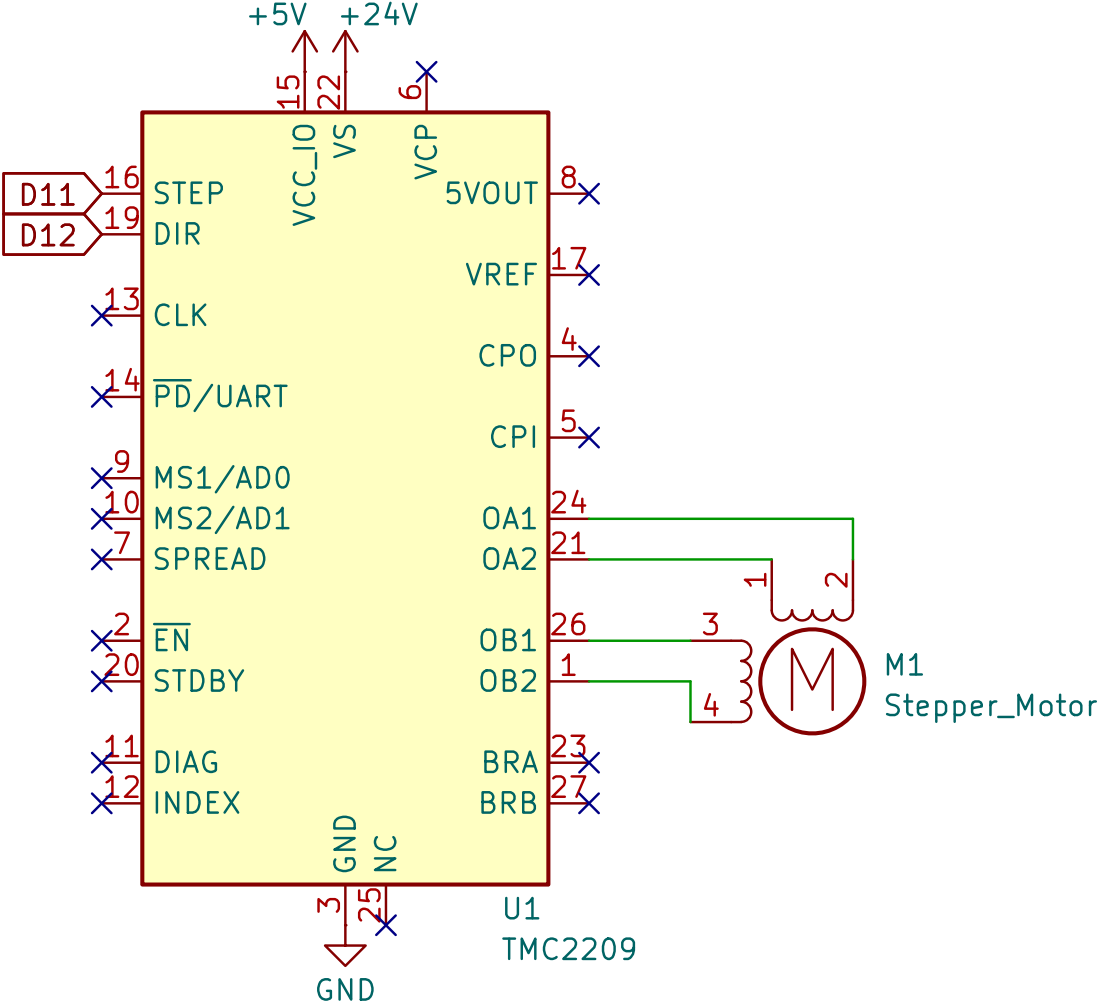
[picture p61: page 1]
