knedl1k/decaf/thesis/fig/schematics/encoder-crop.pdf

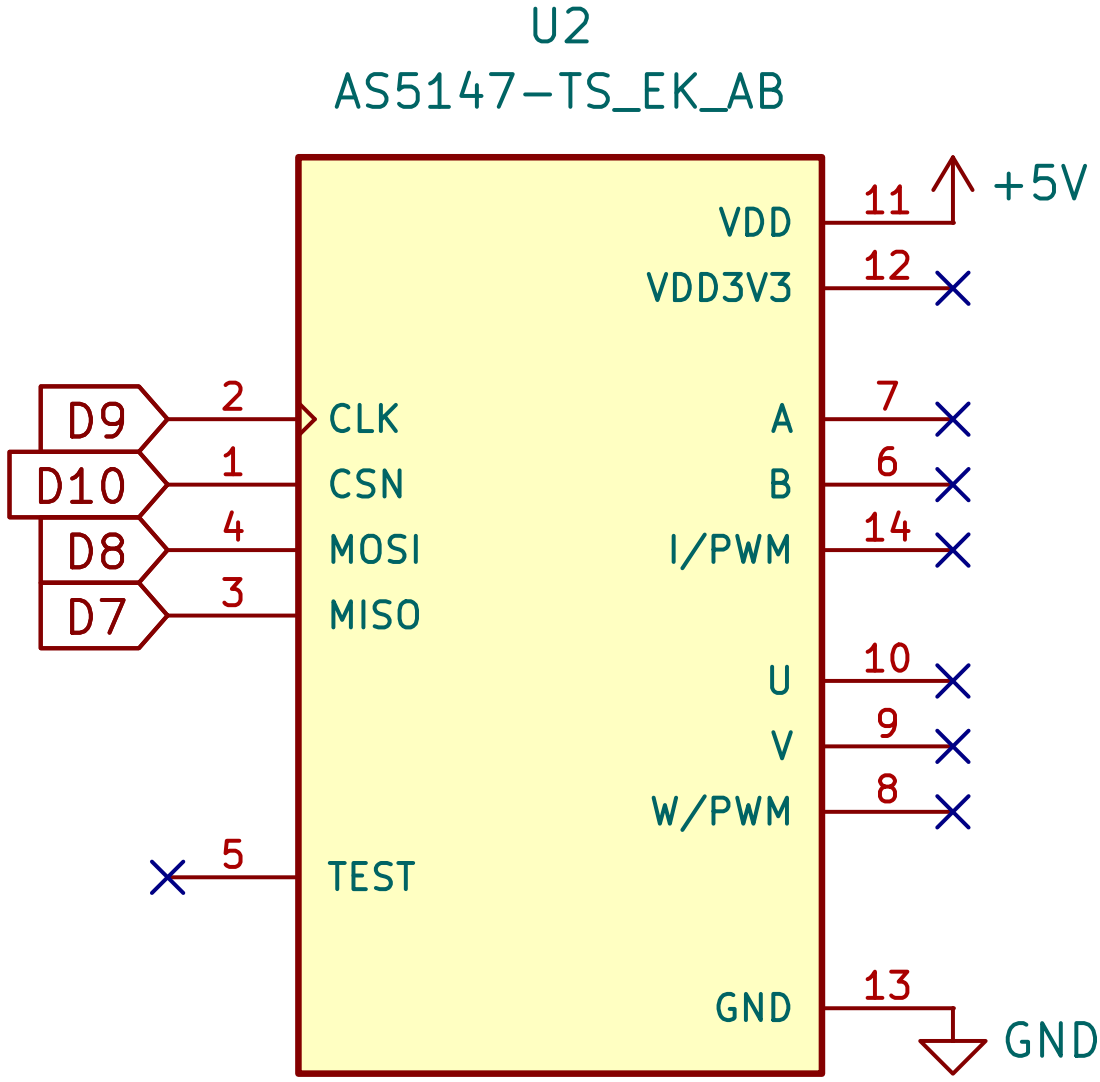
[picture p62: page 1]
