knedl1k/decaf/thesis/fig/schematics/servo-crop.pdf

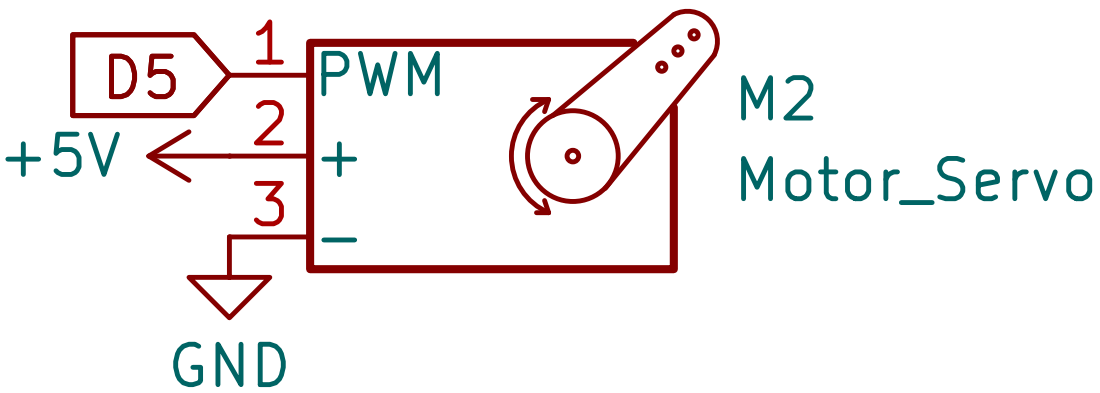
[picture p63: page 1]
