knedl1k/decaf/thesis/fig/schematics/valve-crop.pdf

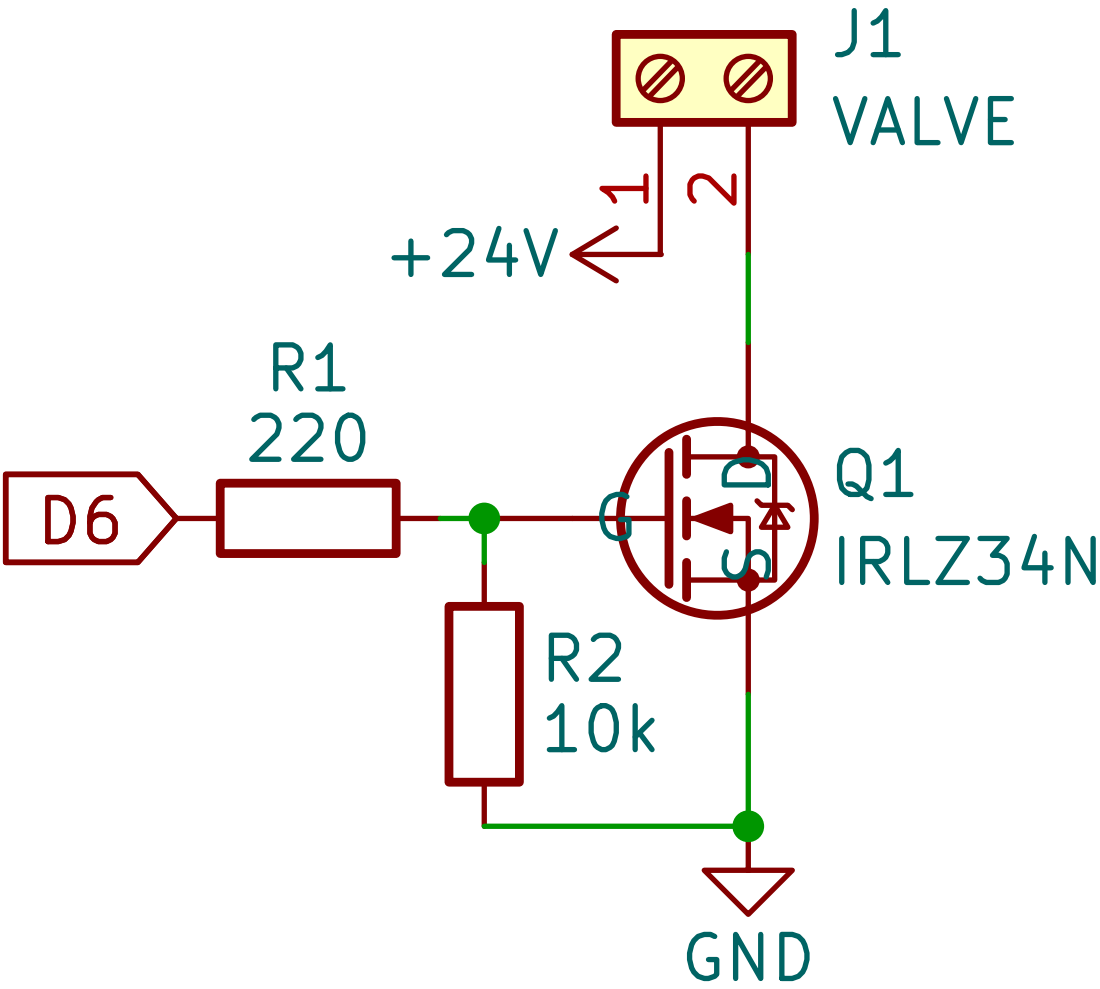
[picture p64: page 1]
