knedl1k/decaf/hw/kicad/driver/driver.kicad_sch

## KiCad design hw/kicad/driver/driver.kicad_sch (2026-05-21)

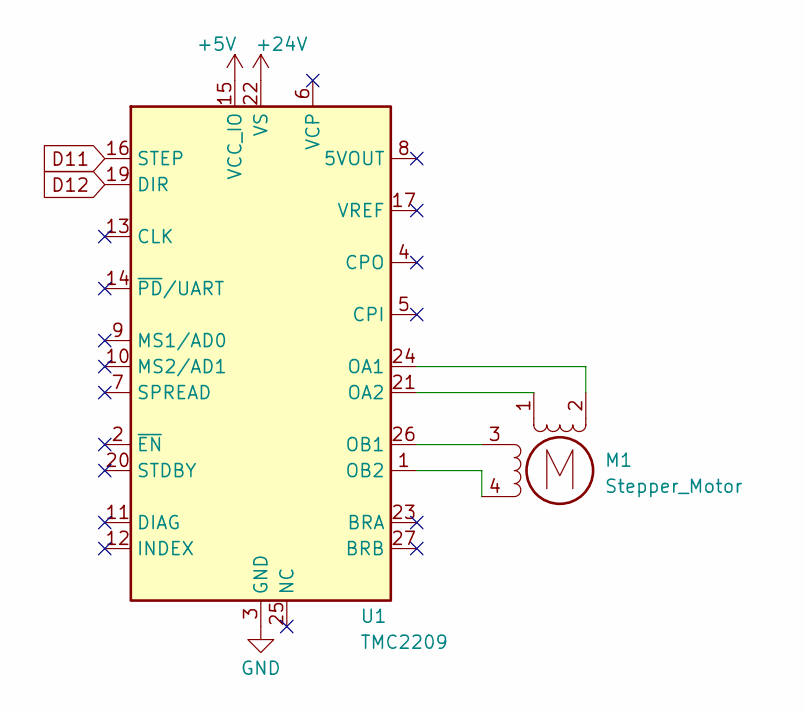
[picture p65: schematic driver.kicad_sch]

Parts:
M1: Stepper_Motor
U1: TMC2209; VQFN-28-1EP_5x5mm_P0.5mm_EP3.7x3.7mm_ThermalVias

Connections:
+5V: U1.15 (VCC_IO)
+24V: U1.22 (VS), U1.28 (VS)
D11: U1.16 (STEP)
D12: U1.19 (DIR)
GND: U1.3 (GND), U1.18 (GND), U1.29 (GND)
unnamed: M1.1, U1.21 (OA2)
unnamed: M1.2 (-), U1.24 (OA1)
unnamed: M1.3, U1.26 (OB1)
unnamed: M1.4, U1.1 (OB2)
