knedl1k/decaf/hw/kicad/valve/valve.kicad_sch

## KiCad design hw/kicad/valve/valve.kicad_sch (2026-05-21)

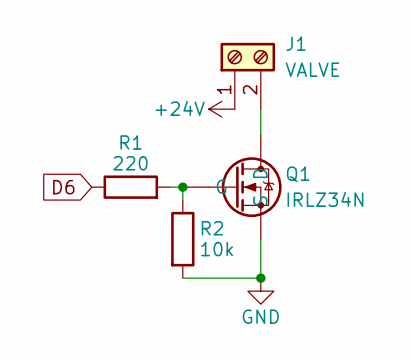
[picture p66: schematic valve.kicad_sch]

Parts:
J1: VALVE
Q1: IRLZ34N; TO-220-3_Vertical
R1: 220
R2: 10k

Connections:
+24V: J1.1
D6: R1.1
GND: Q1.3 (S), R2.2
unnamed: J1.2, Q1.2 (D)
unnamed: Q1.1 (G), R1.2, R2.1
