knedl1k/decaf/(commit log)

2025-10-19 hw: add hand-drawn sketch of a robotic arm
    THe circled items need to be purchased.
2025-11-13 sw/stepper/: add several testing programs
    Simple rotation of a stepper motor, reading data from a magnetic encoder during motor movement.
2025-11-27 sw/stepper/: change of names to comply with Arduino conventions
    ino files should have the same name as the directory in which they are located.
2025-11-27 feat: implement motor rotation using encoder feedback
2025-11-27 style: switch to 4 spaces, remove unused code, cleanup
2025-11-27 docs: add more details about servo
2025-12-01 feat: add magstep circuit
    [magstep.kicad_sch]
2025-12-01 feat: add thesis template
    first version of Introduction
    [hypothesis_2d.csv, hypothesis_3d.csv]
2025-12-09 initial commit of the entire NN for recognition
    Since I hardly know what I'm doing, I didn't want to commit every time I debugged something. This looks more stable now, so I'll put it here. But I already know that there are problems with albumentations, for example.
    [model.py, train.py]
2025-12-09 fix program for uint16 images
    [train.py]
2025-12-16 update design, use better labels
    [magstep.kicad_sch]
2025-12-16 cleanup unused figures
    [hypothesis_2d.csv, hypothesis_3d.csv]
2025-12-31 add debug print
2025-12-31 fix warnings, print only with master
    [train.py]
2026-01-03 standardize filenames and fix naming convetions
    [build_index.py]
2026-01-07 switch to modern abbreviations pkg
2026-01-07 switch from babel to modern variant
2026-01-07 add theoretical framework draft, needs a lot of work
2026-01-10 add FMR metrics for evaluation
    For testing purposes, everything is in one file, then it will be moved.
    We separate 1,000 cards. The model will never "learn" to classify them (they will not have an ID in the last layer), but ArcFace should be able to generate a good vector even for an unseen card. This is the best test of robustness. Each epoch measures how well the augmented and clean versions of these unseen cards match. It then lists the error rate (FMR) when we want to capture 95% of the correct pairs. Ideally, the FMR should drop to zero.
    [train.py]
2026-01-11 switch to new dataset
2026-02-05 add aug diagram, update flow diagram
2026-02-23 replace backbone freezing with differential lr
    Replaced the ugly hard freeze/unfreeze mechanism with AdamW parameter groups (lower LR for the backbone, normal LR for the ArcFace head).
    [train.py]
2026-02-23 add random background instead of black padding
    we try to avoid overfitting on black bgs
    [train.py]
2026-02-23 print cards used for validation
2026-02-23 fix another bunch of errors and warnings
    serialization problems finally fixed, GPU memory context was getting desynchronized
    [train.py]
2026-02-23 fix the random bg pipeline
    I completely missed that bg should be applied actually to the background...
    [train.py]
2026-02-26 make the train loop as clean as possible
    this was a beast, companion helper functions will follow shortly
    [train.py]
2026-03-09 fix typos, introduce better flow diagram
2026-03-10 merge thresholds & FMR; track LR
    also fix the *100 typo
    [train.py, utils.py]
2026-03-10 fix usage of flags
    [build_index.py]
2026-03-12 switch to gpufast
2026-04-04 print (in)correctly recognized cards
    [evaluate_labeled.py]
2026-04-09 correct arcface implementation hopefully
    [model.py]
2026-04-10 fix offset in eval print
    [train.py]
2026-04-12 add debug prints
2026-04-12 fix typo, names are already clean strings
    [utils.py]
2026-04-17 improve the model architecture flow diagram
2026-04-26 add BOM to 03_hardware
2026-04-26 add pneumatics
2026-04-27 improve the flow chart
    remove newline from the Query image
2026-04-28 add second valve datasheet
2026-04-30 add schematics for solenoid valve
2026-04-30 add schematics for driver & encoder
2026-04-30 separate every schematics into its own project
    [all.kicad_sch, driver.kicad_pcb, driver.kicad_sch, encoder.kicad_pcb, encoder.kicad_sch, magstep.kicad_sch, valve.kicad_pcb, valve.kicad_sch]
2026-05-02 add top-down, add rest of the components to BOM
2026-05-02 add exact model number for power supply
2026-05-02 small formatting changes
    [valve.kicad_sch]
2026-05-03 rpi camera should be outside the area
2026-05-04 fix bug with precision
    both must me in autocast to compare them at the same precision
    [utils.py]
2026-05-04 fix real_top1 not saving
    history updating and printing is now after the real_top1 calculation
    [train.py, utils.py]
2026-05-06 add some eval graphs
    [bar_data.csv, hist_data.csv, training_history.csv]
2026-05-09 add venturi render, better arm assemly render
2026-05-10 reflect new naming scheme
    [bar_data.csv, hist_data.csv, train_data.csv, training_history.csv]
2026-05-11 update graphs with bigger dataset
    [bar_data.csv, hist_data.csv]
2026-05-13 add price for MOSFET, minor text improvement
2026-05-16 fix some bugs
    introduced in the rewrite
    [evaluate_labeled.py]
2026-05-18 add servo schematic
    [servo.kicad_pcb, servo.kicad_sch]
2026-05-18 add exact name+edition matching cosine similarity
    [hist_data.csv]
2026-05-18 rework the 3D printed appendix
    simple table with stl file names
2026-05-21 update schematics
    [driver.kicad_sch, encoder.kicad_sch, servo.kicad_sch, valve.kicad_sch]
2026-05-22 no wraparound, fixed some bugs
    [magstep.ino]
2026-05-22 add a utility to determine the servo angle
2026-05-22 add main loop ran on arduino
2026-05-22 match changes made in the assembly
2026-05-22 add implementation of arduino code
2026-05-22 arduino mega -> uno
2026-05-22 add brand-new inference script with arduino management
2026-05-22 mv everything into kicad dir
    [all.kicad_sch, driver.kicad_pcb, driver.kicad_sch, encoder.kicad_pcb, encoder.kicad_sch, servo.kicad_pcb, servo.kicad_sch, valve.kicad_pcb]
2026-05-22 add STLs
    [ArmBody.stl, ArmDoubleSided.stl, BaseOffset.stl, CardHolder.stl, DummyArm.stl, Linkage.stl, MotorHousing.stl, MotorMount.stl]
2026-05-22 add photo of the prototype
