knedl1k/decaf/(notices)

Notices in the files:
README.md:
License: AGPL v3
